lucblender/MultiTool-Midi-Board/Hardware/multi-tool-midi-board/multi-tool-midi-board.kicad_pcb

## KiCad design Hardware/multi-tool-midi-board/multi-tool-midi-board.kicad_pcb (2023-04-30)

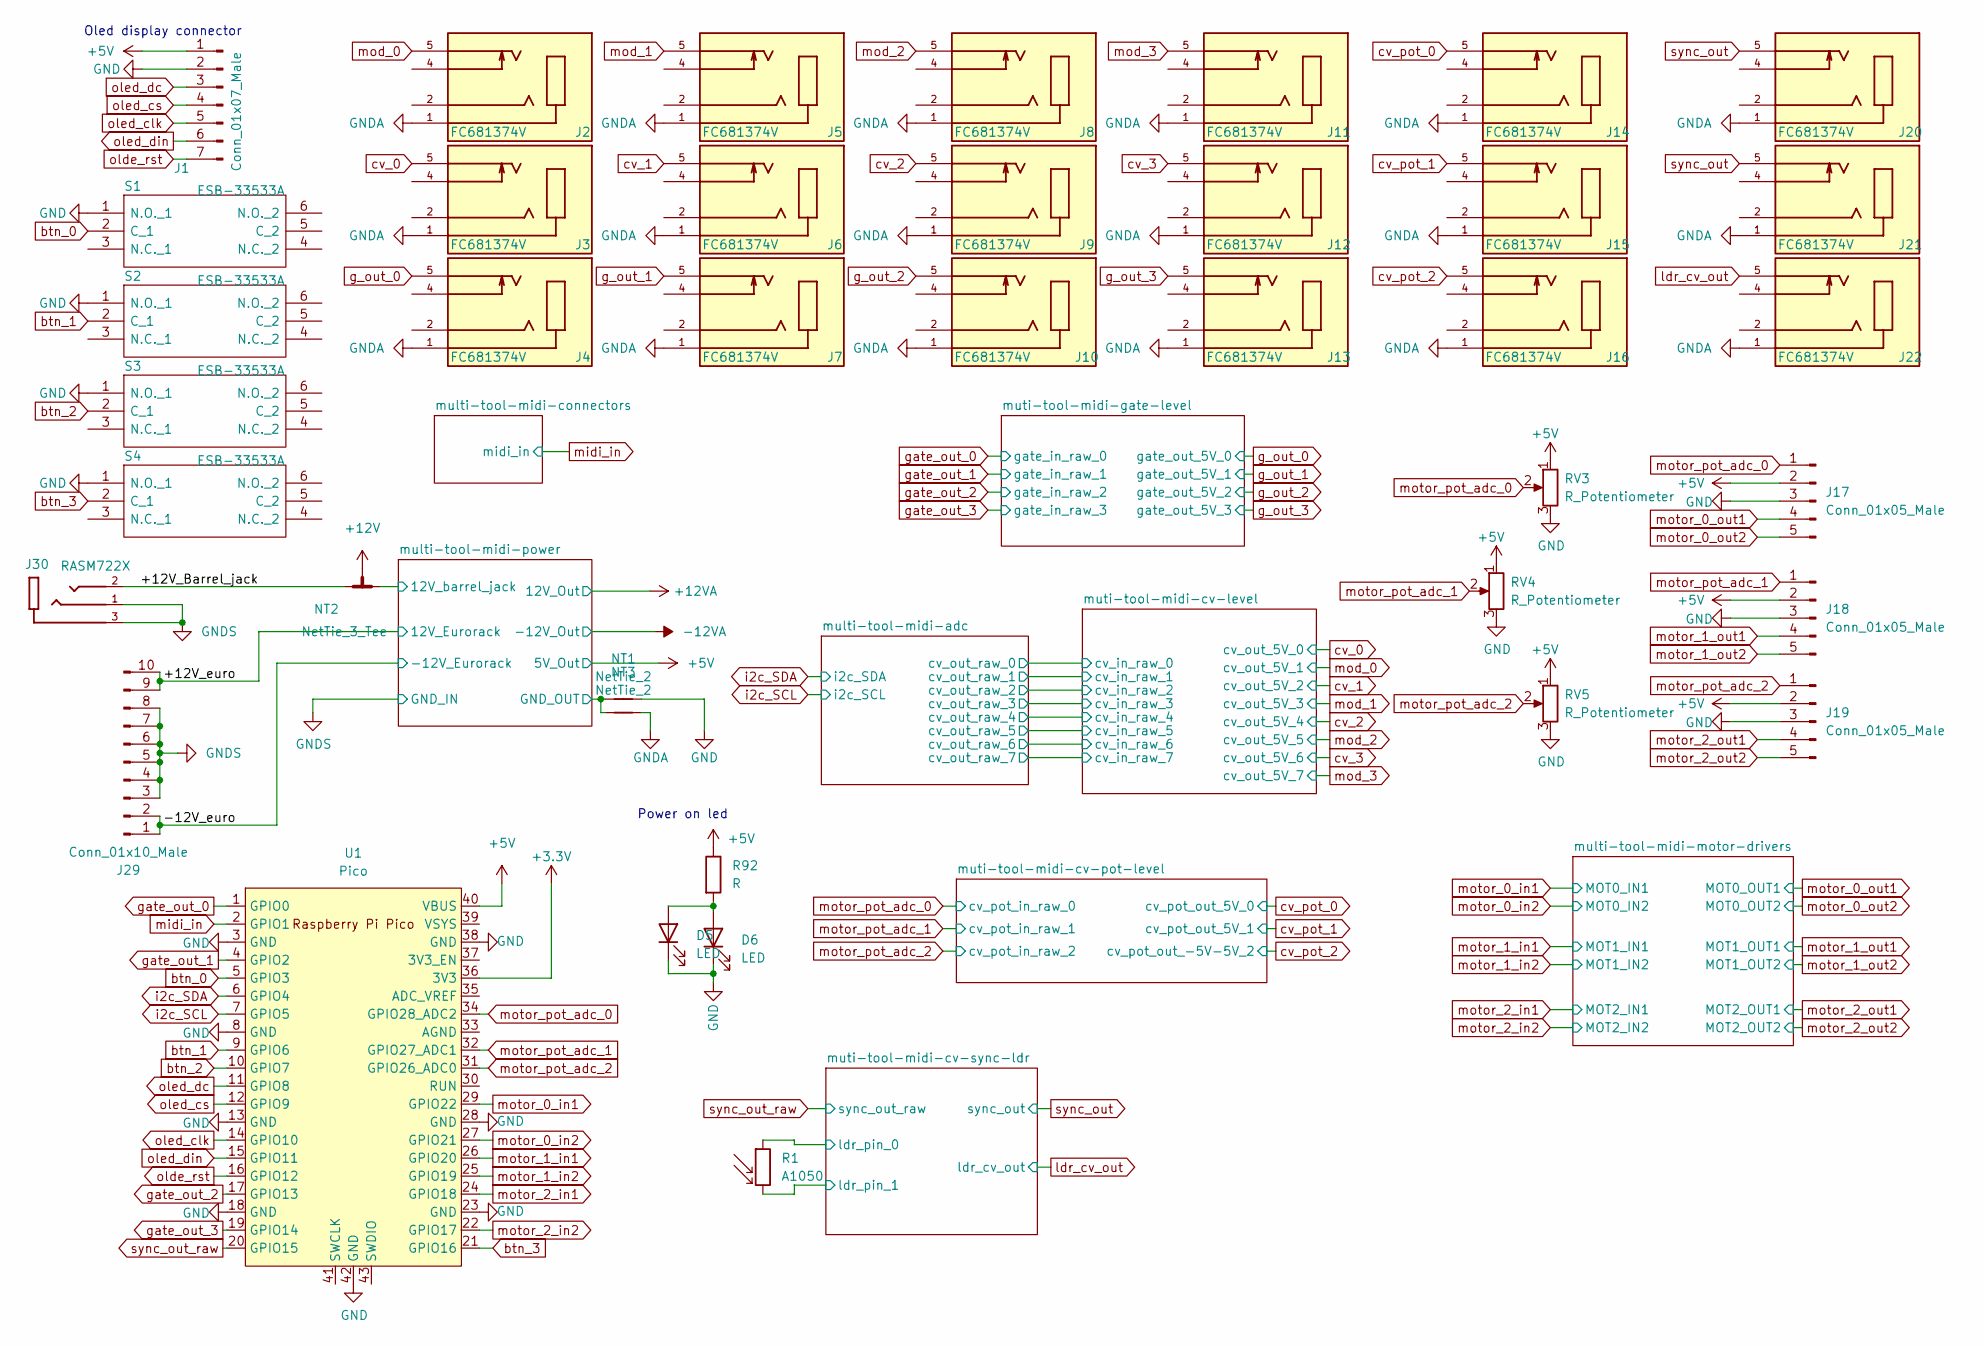
[picture p1: schematic multi-tool-midi-board.kicad_sch, Multi tool midi board]

Parts:
D5: LED; LED_D3.0mm
D6: LED; LED_0603_1608Metric
J1: Conn_01x07_Male; PinHeader_1x07_P2.54mm_Vertical
J2, J3, J4, J5, J6, J7, J8, J9, J10, J11, J12, J13, J14, J15, J16, J20, J21, J22: FC681374V; CLIFF_FC681374V
J17, J18, J19: Conn_01x05_Male; PinHeader_1x05_P2.54mm_Vertical
J29: Conn_01x10_Male; PinHeader_2x05_P2.54mm_Vertical
J30: RASM722X; SWITCHCRAFT_RASM722X; PARTREV A
NT1, NT3: NetTie_2; NetTie-2_SMD_Pad2.0mm
NT2: NetTie_3_Tee; NetTie-3_SMD_Pad2.0mm
R1: A1050; R_LDR_D6.4mm_P3.4mm_Vertical
R92: R; R_0805_2012Metric
RV3, RV4, RV5: R_Potentiometer; Potentiometer_Alpha_RD901F-40-00D_Single_Vertical
S1, S2, S3, S4: ESB-33533A; ESB33533A; Mouser Part Number 667-ESB-33533A
U1: Pico; RPi_Pico_SMD_TH

Connections:
+3V3: U1.36 (3V3); also elsewhere on the board
+5V: J1.1, J17.2, J18.2, J19.2, R92.1, RV3.1, RV4.1, RV5.1, U1.40 (VBUS); also elsewhere on the board
+12V: NT2.3; also elsewhere on the board
+12VA: R1.1; also elsewhere on the board
/+12V_Barrel_jack: J30.2, NT2.2
/+12V_euro: J29.9, J29.10; also elsewhere on the board
/-12V_euro: J29.1, J29.2; also elsewhere on the board
/multi-tool-midi-power/12V_barrel_jack: NT2.1; also elsewhere on the board
/muti-tool-midi-cv-sync-ldr/ldr_pin_1: R1.2; also elsewhere on the board
GND: D5.1 (K), D6.1 (K), J1.2, J17.3, J18.3, J19.3, NT1.2, RV3.3, RV4.3, RV5.3, S1.1 (N.O._1), S2.1 (N.O._1), S3.1 (N.O._1), S4.1 (N.O._1), U1.3 (GND), U1.8 (GND), U1.13 (GND), U1.18 (GND), U1.23 (GND), U1.28 (GND), U1.38 (GND), U1.42 (GND); also elsewhere on the board
GNDA: J2.1, J3.1, J4.1, J5.1, J6.1, J7.1, J8.1, J9.1, J10.1, J11.1, J12.1, J13.1, J14.1, J15.1, J16.1, J20.1, J21.1, J22.1, NT3.2; also elsewhere on the board
GNDS: J29.3, J29.4, J29.5, J29.6, J29.7, J29.8, J30.1, J30.3, NT1.1, NT3.1; also elsewhere on the board
unnamed: D5.2 (A), D6.2 (A), R92.2
btn_0: S1.2 (C_1), U1.5 (GPIO3)
btn_1: S2.2 (C_1), U1.9 (GPIO6)
btn_2: S3.2 (C_1), U1.10 (GPIO7)
btn_3: S4.2 (C_1), U1.21 (GPIO16)
cv_0: J3.5; also elsewhere on the board
cv_1: J6.5; also elsewhere on the board
cv_2: J9.5; also elsewhere on the board
cv_3: J12.5; also elsewhere on the board
cv_pot_0: J14.5; also elsewhere on the board
cv_pot_1: J15.5; also elsewhere on the board
cv_pot_2: J16.5; also elsewhere on the board
g_out_0: J4.5; also elsewhere on the board
g_out_1: J7.5; also elsewhere on the board
g_out_2: J10.5; also elsewhere on the board
g_out_3: J13.5; also elsewhere on the board
gate_out_0: U1.1 (GPIO0); also elsewhere on the board
gate_out_1: U1.4 (GPIO2); also elsewhere on the board
gate_out_2: U1.17 (GPIO13); also elsewhere on the board
gate_out_3: U1.19 (GPIO14); also elsewhere on the board
i2c_SCL: U1.7 (GPIO5); also elsewhere on the board
i2c_SDA: U1.6 (GPIO4); also elsewhere on the board
ldr_cv_out: J22.5; also elsewhere on the board
midi_in: U1.2 (GPIO1); also elsewhere on the board
mod_0: J2.5; also elsewhere on the board
mod_1: J5.5; also elsewhere on the board
mod_2: J8.5; also elsewhere on the board
mod_3: J11.5; also elsewhere on the board
motor_0_in1: U1.29 (GPIO22); also elsewhere on the board
motor_0_in2: U1.27 (GPIO21); also elsewhere on the board
motor_0_out1: J17.4; also elsewhere on the board
motor_0_out2: J17.5; also elsewhere on the board
motor_1_in1: U1.26 (GPIO20); also elsewhere on the board
motor_1_in2: U1.25 (GPIO19); also elsewhere on the board
motor_1_out1: J18.4; also elsewhere on the board
motor_1_out2: J18.5; also elsewhere on the board
motor_2_in1: U1.24 (GPIO18); also elsewhere on the board
motor_2_in2: U1.22 (GPIO17); also elsewhere on the board
motor_2_out1: J19.4; also elsewhere on the board
motor_2_out2: J19.5; also elsewhere on the board
motor_pot_adc_0: J17.1, RV3.2, U1.34 (GPIO28_ADC2); also elsewhere on the board
motor_pot_adc_1: J18.1, RV4.2, U1.32 (GPIO27_ADC1); also elsewhere on the board
motor_pot_adc_2: J19.1, RV5.2, U1.31 (GPIO26_ADC0); also elsewhere on the board
olde_rst: J1.7, U1.16 (GPIO12)
oled_clk: J1.5, U1.14 (GPIO10)
oled_cs: J1.4, U1.12 (GPIO9)
oled_dc: J1.3, U1.11 (GPIO8)
oled_din: J1.6, U1.15 (GPIO11)
sync_out: J20.5, J21.5; also elsewhere on the board
sync_out_raw: U1.20 (GPIO15); also elsewhere on the board

Notes on the sheet:
Power on led
Oled display connector

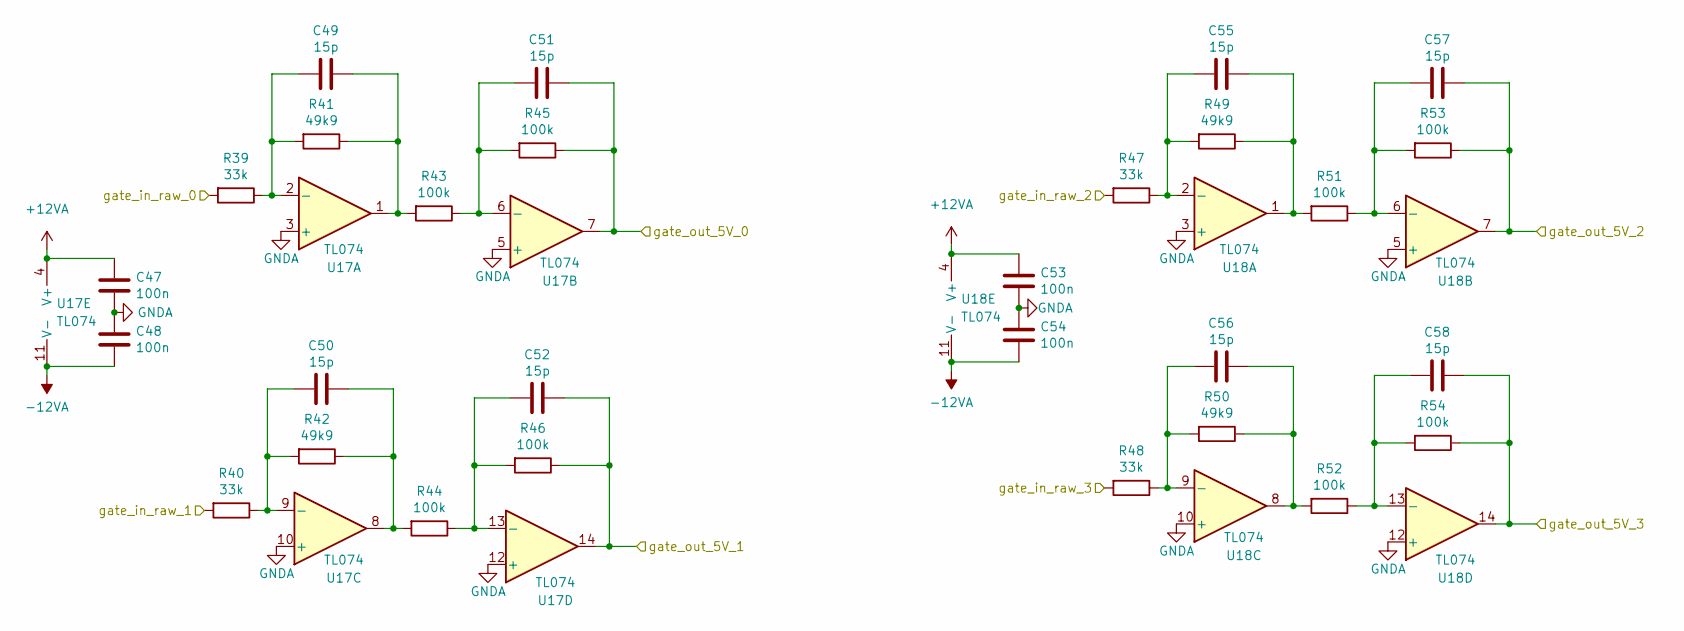
[picture p2: schematic muti-tool-midi-gate-level.kicad_sch]

Parts:
C47, C48, C53, C54: 100n; C_0603_1608Metric; LCSC C14663
C49, C50, C51, C52, C55, C56, C57, C58: 15p; C_0603_1608Metric; LCSC C14663
R39, R40, R47, R48: 33k; R_0603_1608Metric; LCSC C25804
R41, R42, R49, R50: 49k9; R_0603_1608Metric; LCSC C25804
R43, R44, R45, R46, R51, R52, R53, R54: 100k; R_0603_1608Metric; LCSC C25804
U17, U18: TL074; SOP50P326X110-14N

Connections:
+12VA: C47.1, C53.1, U17.4 (V+), U18.4 (V+); also elsewhere on the board
-12VA: C48.2, C54.2, U17.11 (V-), U18.11 (V-); also elsewhere on the board
GNDA: C47.2, C48.1, C53.2, C54.1, U17.3 (+), U17.5 (+), U17.10 (+), U17.12 (+), U18.3 (+), U18.5 (+), U18.10 (+), U18.12 (+); also elsewhere on the board
unnamed: C49.1, R39.1, R41.2, U17.2 (-)
unnamed: C49.2, R41.1, R43.2, U17.1
unnamed: C50.1, R40.1, R42.2, U17.9 (-)
unnamed: C50.2, R42.1, R44.2, U17.8
unnamed: C51.1, R43.1, R45.2, U17.6 (-)
unnamed: C52.1, R44.1, R46.2, U17.13 (-)
unnamed: C55.1, R47.1, R49.2, U18.2 (-)
unnamed: C55.2, R49.1, R51.2, U18.1
unnamed: C56.1, R48.1, R50.2, U18.9 (-)
unnamed: C56.2, R50.1, R52.2, U18.8
unnamed: C57.1, R51.1, R53.2, U18.6 (-)
unnamed: C58.1, R52.1, R54.2, U18.13 (-)
g_out_0: C51.2, R45.1, U17.7; also elsewhere on the board
g_out_1: C52.2, R46.1, U17.14; also elsewhere on the board
g_out_2: C57.2, R53.1, U18.7; also elsewhere on the board
g_out_3: C58.2, R54.1, U18.14; also elsewhere on the board
gate_out_0: R39.2; also elsewhere on the board
gate_out_1: R40.2; also elsewhere on the board
gate_out_2: R47.2; also elsewhere on the board
gate_out_3: R48.2; also elsewhere on the board

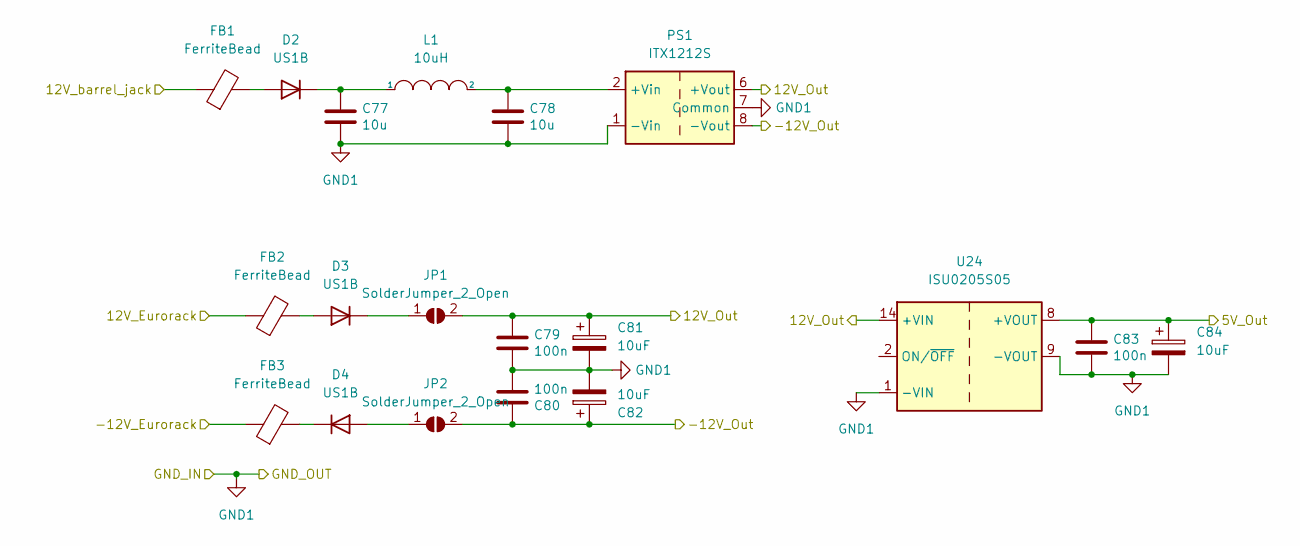
[picture p3: schematic multi-tool-midi-power.kicad_sch]

Parts:
C77, C78: 10u; C_0603_1608Metric; LCSC C14663
C79, C80, C83: 100n; C_0603_1608Metric; LCSC C14663
C81, C82, C84: 10uF; CP_Elec_6.3x5.9
D2, D3, D4: US1B; D_SMA
FB1, FB2, FB3: FerriteBead; L_0805_2012Metric
JP1, JP2: SolderJumper_2_Open; SolderJumper-2_P1.3mm_Open_TrianglePad1.0x1.5mm
L1: 10uH; L_0805_2012Metric
PS1: ITX1212S; Converter_DCDC_XP_POWER-ITxxxxxS_THT
U24: ISU0205S05; Converter_DCDC_XP_POWER-ISU02_SMD

Connections:
+5V: C83.1, C84.1, U24.8 (+VOUT); also elsewhere on the board
+12VA: C79.1, C81.1, JP1.2 (B), PS1.6 (+Vout), U24.14 (+VIN); also elsewhere on the board
-12VA: C80.1, C82.1, JP2.2 (B), PS1.8 (-Vout); also elsewhere on the board
/+12V_euro: FB2.1; also elsewhere on the board
/-12V_euro: FB3.1; also elsewhere on the board
/multi-tool-midi-power/12V_barrel_jack: FB1.1; also elsewhere on the board
GNDS: C77.2, C78.2, C79.2, C80.2, C81.2, C82.2, C83.2, C84.2, PS1.1 (-Vin), PS1.7 (Common), U24.1 (-VIN), U24.9 (-VOUT); also elsewhere on the board
unnamed: C77.1, D2.1 (K), L1.1
unnamed: C78.1, L1.2, PS1.2 (+Vin)
unnamed: D2.2 (A), FB1.2
unnamed: D3.1 (K), JP1.1 (A)
unnamed: D3.2 (A), FB2.2
unnamed: D4.1 (K), FB3.2
unnamed: D4.2 (A), JP2.1 (A)

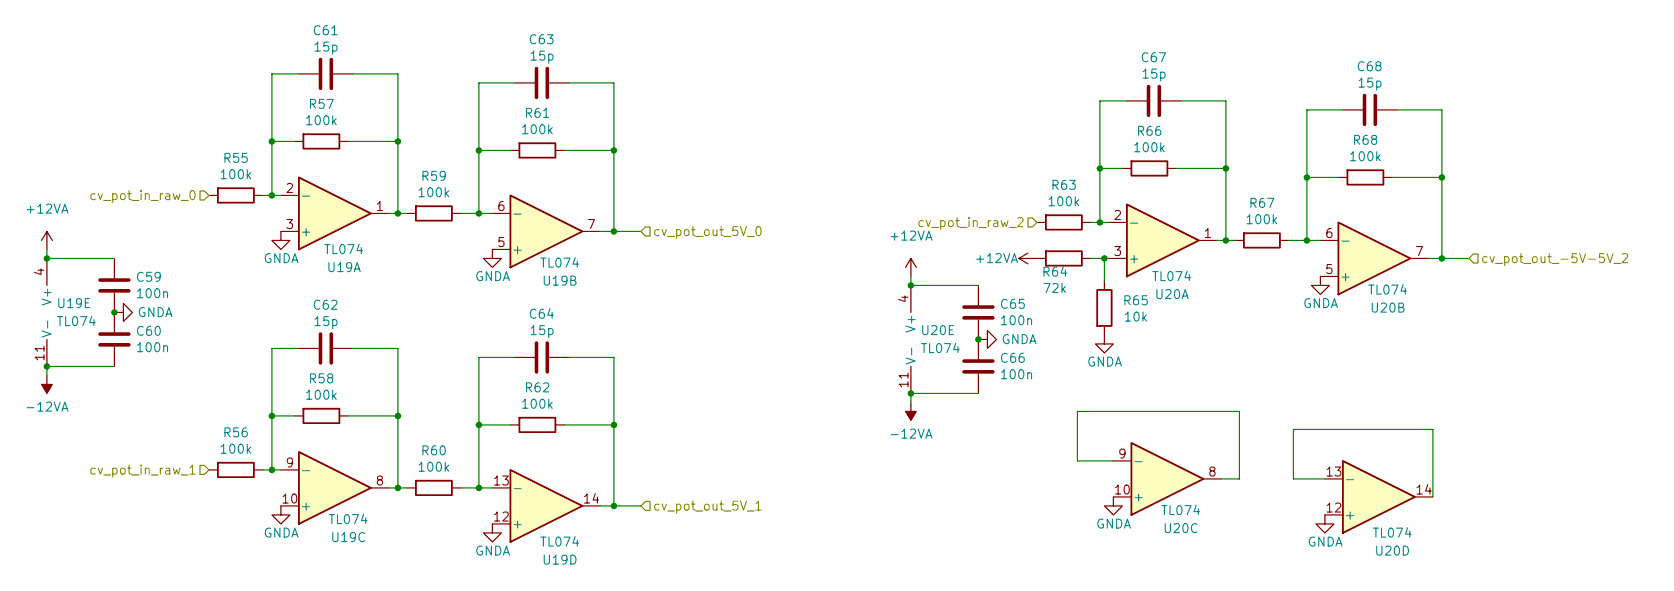
[picture p4: schematic muti-tool-midi-cv-pot-level.kicad_sch]

Parts:
C59, C60, C65, C66: 100n; C_0603_1608Metric; LCSC C14663
C61, C62, C63, C64, C67, C68: 15p; C_0603_1608Metric; LCSC C14663
R55, R56, R57, R58, R59, R60, R61, R62, R63, R66, R67, R68: 100k; R_0603_1608Metric; LCSC C25804
R64: 72k; R_0603_1608Metric; LCSC C25804
R65: 10k; R_0603_1608Metric; LCSC C25804
U19, U20: TL074; SOP50P326X110-14N

Connections:
+12VA: C59.1, C65.1, R64.2, U19.4 (V+), U20.4 (V+); also elsewhere on the board
-12VA: C60.2, C66.2, U19.11 (V-), U20.11 (V-); also elsewhere on the board
GNDA: C59.2, C60.1, C65.2, C66.1, R65.2, U19.3 (+), U19.5 (+), U19.10 (+), U19.12 (+), U20.5 (+), U20.10 (+), U20.12 (+); also elsewhere on the board
unnamed: C61.1, R55.1, R57.2, U19.2 (-)
unnamed: C61.2, R57.1, R59.2, U19.1
unnamed: C62.1, R56.1, R58.2, U19.9 (-)
unnamed: C62.2, R58.1, R60.2, U19.8
unnamed: C63.1, R59.1, R61.2, U19.6 (-)
unnamed: C64.1, R60.1, R62.2, U19.13 (-)
unnamed: C67.1, R63.1, R66.2, U20.2 (-)
unnamed: C67.2, R66.1, R67.2, U20.1
unnamed: C68.1, R67.1, R68.2, U20.6 (-)
unnamed: R64.1, R65.1, U20.3 (+)
unnamed: U20.8, U20.9 (-)
unnamed: U20.13 (-), U20.14
cv_pot_0: C63.2, R61.1, U19.7; also elsewhere on the board
cv_pot_1: C64.2, R62.1, U19.14; also elsewhere on the board
cv_pot_2: C68.2, R68.1, U20.7; also elsewhere on the board
motor_pot_adc_0: R55.2; also elsewhere on the board
motor_pot_adc_1: R56.2; also elsewhere on the board
motor_pot_adc_2: R63.2; also elsewhere on the board

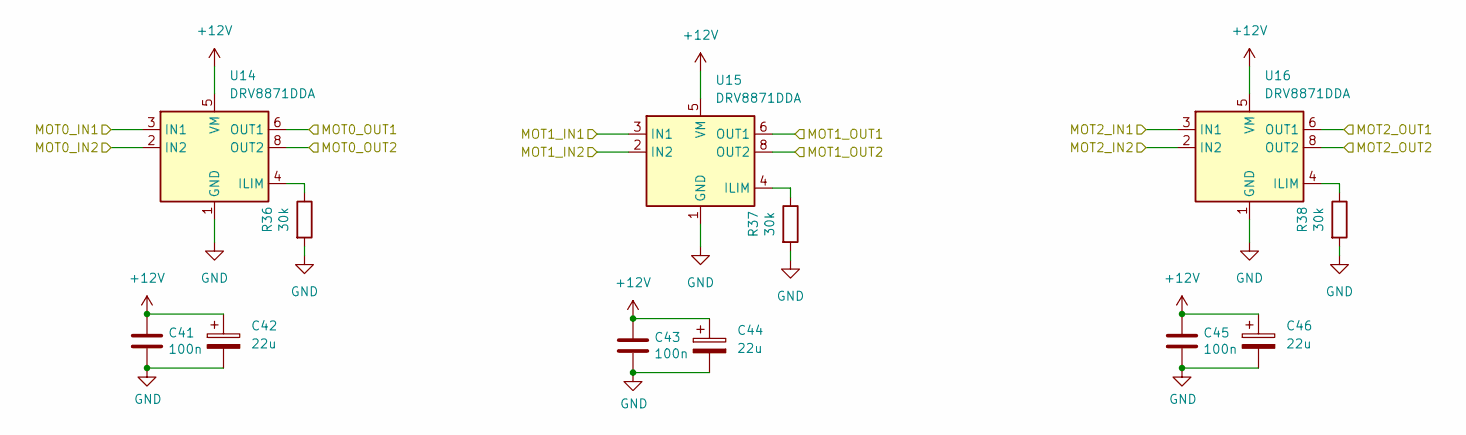
[picture p5: schematic multi-tool-midi-motor-drivers.kicad_sch]

Parts:
C41, C43, C45: 100n; C_0603_1608Metric; LCSC C14663
C42, C44, C46: 22u; CP_Elec_6.3x5.9
R36, R37, R38: 30k; R_0603_1608Metric; LCSC C25804
U14, U15, U16: DRV8871DDA; Texas_HTSOP-8-1EP_3.9x4.9mm_P1.27mm_EP2.95x4.9mm_Mask2.4x3.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

Connections:
+12V: C41.1, C42.1, C43.1, C44.1, C45.1, C46.1, U14.5 (VM), U15.5 (VM), U16.5 (VM); also elsewhere on the board
GND: C41.2, C42.2, C43.2, C44.2, C45.2, C46.2, R36.2, R37.2, R38.2, U14.1 (GND), U14.7 (GND), U14.9 (GND), U15.1 (GND), U15.7 (GND), U15.9 (GND), U16.1 (GND), U16.7 (GND), U16.9 (GND); also elsewhere on the board
unnamed: R36.1, U14.4 (ILIM)
unnamed: R37.1, U15.4 (ILIM)
unnamed: R38.1, U16.4 (ILIM)
motor_0_in1: U14.3 (IN1); also elsewhere on the board
motor_0_in2: U14.2 (IN2); also elsewhere on the board
motor_0_out1: U14.6 (OUT1); also elsewhere on the board
motor_0_out2: U14.8 (OUT2); also elsewhere on the board
motor_1_in1: U15.3 (IN1); also elsewhere on the board
motor_1_in2: U15.2 (IN2); also elsewhere on the board
motor_1_out1: U15.6 (OUT1); also elsewhere on the board
motor_1_out2: U15.8 (OUT2); also elsewhere on the board
motor_2_in1: U16.3 (IN1); also elsewhere on the board
motor_2_in2: U16.2 (IN2); also elsewhere on the board
motor_2_out1: U16.6 (OUT1); also elsewhere on the board
motor_2_out2: U16.8 (OUT2); also elsewhere on the board

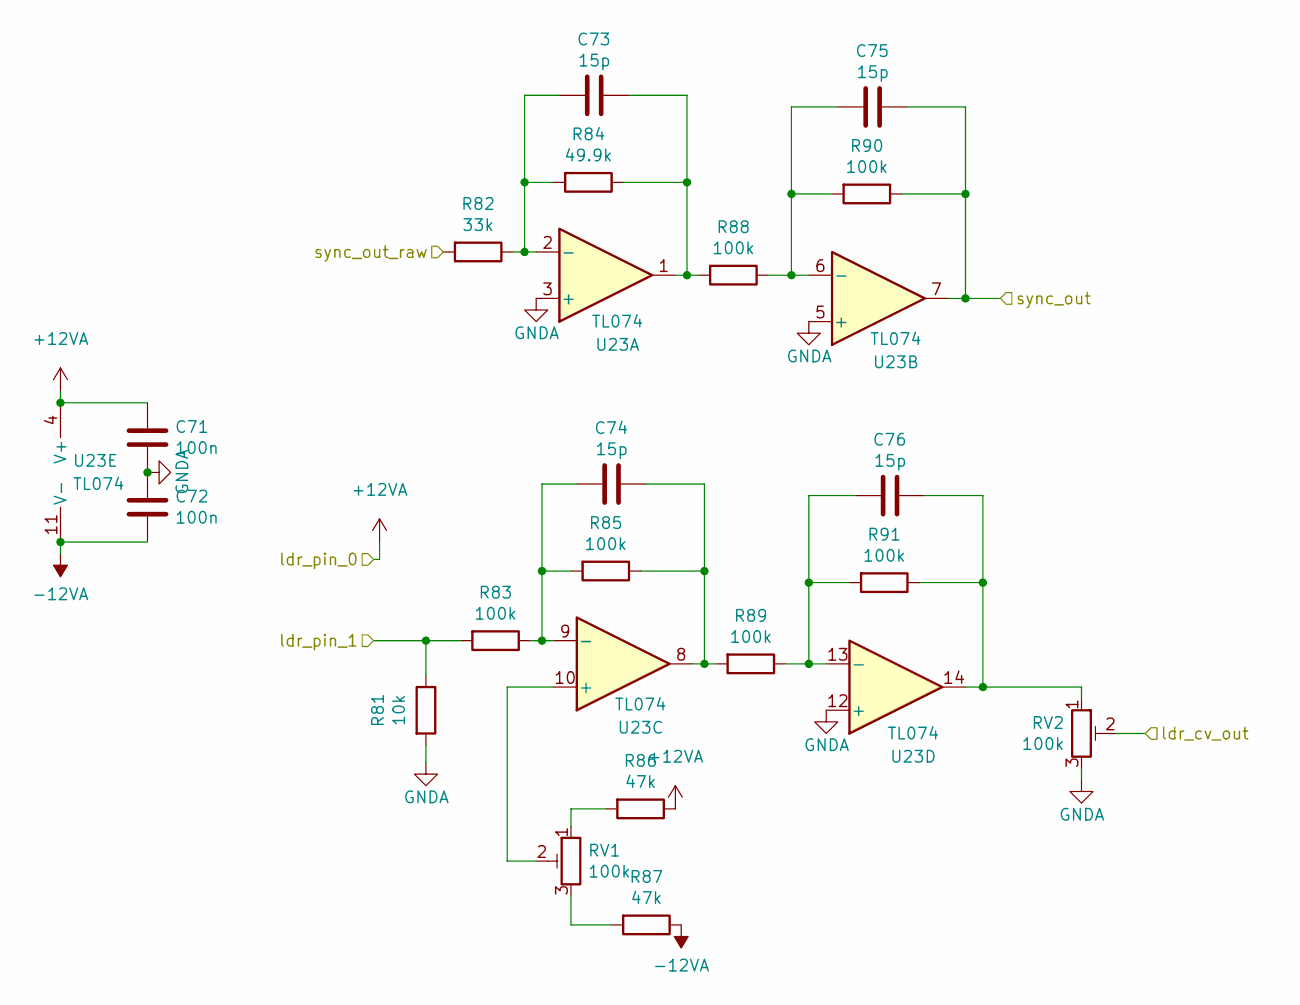
[picture p6: schematic muti-tool-midi-cv-sync-ldr.kicad_sch]

Parts:
C71, C72: 100n; C_0603_1608Metric; LCSC C14663
C73, C74, C75, C76: 15p; C_0603_1608Metric; LCSC C14663
R81: 10k; R_0603_1608Metric; LCSC C25804
R82: 33k; R_0603_1608Metric; LCSC C25804
R83, R85, R88, R89, R90, R91: 100k; R_0603_1608Metric; LCSC C25804
R84: 49.9k; R_0603_1608Metric; LCSC C25804
R86, R87: 47k; R_0603_1608Metric; LCSC C25804
RV1, RV2: 100k; Potentiometer_Vishay_TS53YL_Vertical
U23: TL074; SOP50P326X110-14N

Connections:
+12VA: C71.1, R86.1, U23.4 (V+); also elsewhere on the board
-12VA: C72.2, R87.1, U23.11 (V-); also elsewhere on the board
/muti-tool-midi-cv-sync-ldr/ldr_pin_1: R81.1, R83.2; also elsewhere on the board
GNDA: C71.2, C72.1, R81.2, RV2.3, U23.3 (+), U23.5 (+), U23.12 (+); also elsewhere on the board
unnamed: C73.1, R82.1, R84.2, U23.2 (-)
unnamed: C73.2, R84.1, R88.2, U23.1
unnamed: C74.1, R83.1, R85.2, U23.9 (-)
unnamed: C74.2, R85.1, R89.2, U23.8
unnamed: C75.1, R88.1, R90.2, U23.6 (-)
unnamed: C76.1, R89.1, R91.2, U23.13 (-)
unnamed: C76.2, R91.1, RV2.1, U23.14
unnamed: R86.2, RV1.1
unnamed: R87.2, RV1.3
unnamed: RV1.2, U23.10 (+)
ldr_cv_out: RV2.2; also elsewhere on the board
sync_out: C75.2, R90.1, U23.7; also elsewhere on the board
sync_out_raw: R82.2; also elsewhere on the board

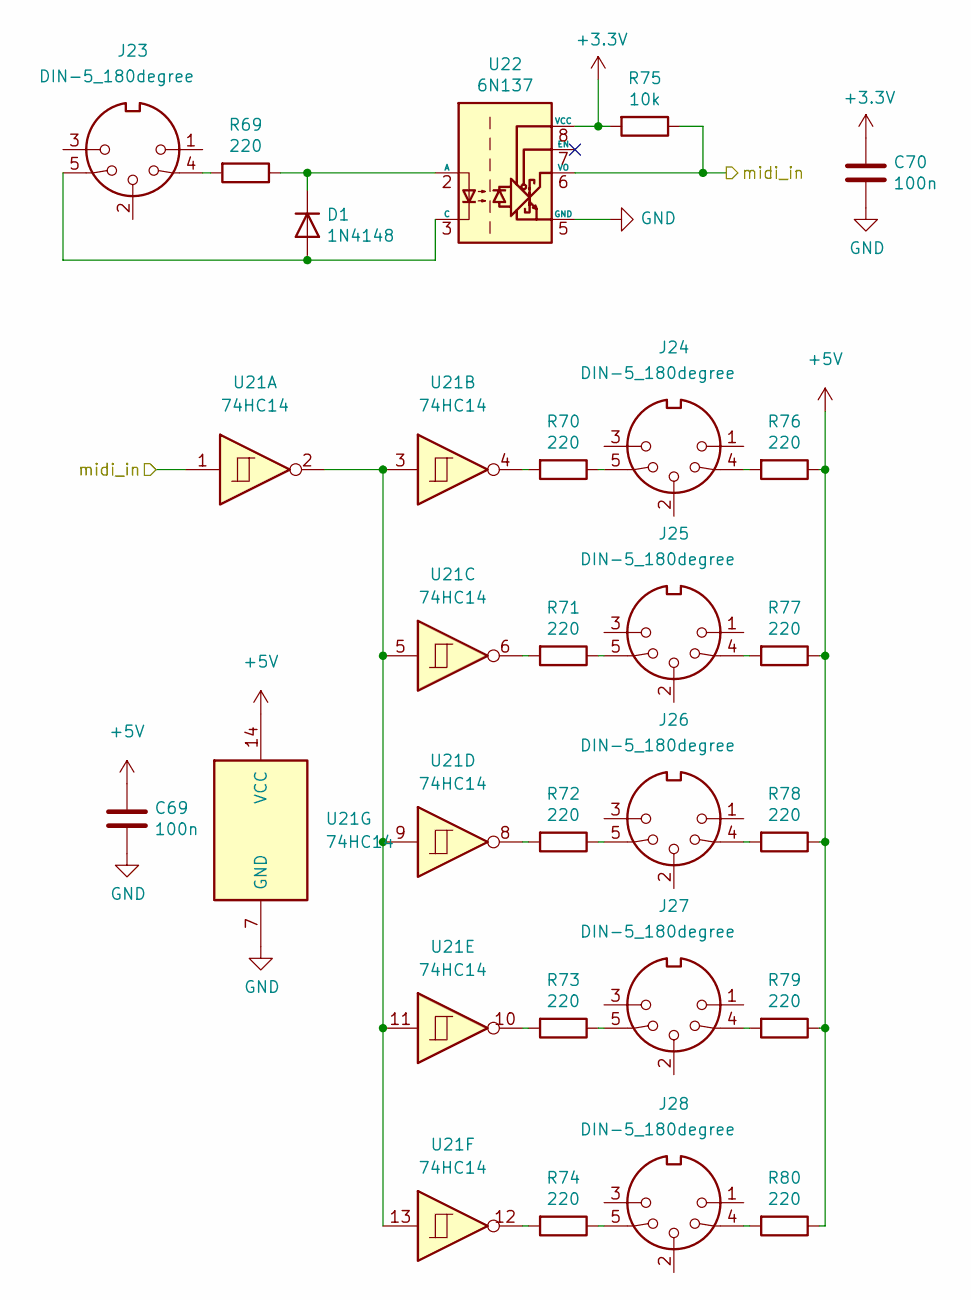
[picture p7: schematic multi-tool-midi-connectors.kicad_sch]

Parts:
C69, C70: 100n; C_0603_1608Metric; LCSC C14663
D1: 1N4148; D_SOD-123; LCSC C81598
J23, J24, J25, J26, J27, J28: DIN-5_180degree; CUI_SD-50BV
R69: 220; R_0603_1608Metric; LCSC C22962
R70, R71, R72, R73, R74, R76, R77, R78, R79, R80: 220; R_0603_1608Metric; LCSC C25804
R75: 10k; R_0603_1608Metric; LCSC C25804
U21: 74HC14; SOIC-14_3.9x8.7mm_P1.27mm
U22: 6N137; SMDIP-8_W9.53mm; LCSC C110020

Connections:
+3V3: C70.1, R75.2, U22.8 (VCC); also elsewhere on the board
+5V: C69.1, R76.1, R77.1, R78.1, R79.1, R80.1, U21.14 (VCC); also elsewhere on the board
GND: C69.2, C70.2, U21.7 (GND), U22.5 (GND); also elsewhere on the board
unnamed: D1.1 (K), R69.1, U22.2 (A)
unnamed: D1.2 (A), J23.5, U22.3 (C)
unnamed: J23.4, R69.2
unnamed: J24.4, R76.2
unnamed: J24.5, R70.1
unnamed: J25.4, R77.2
unnamed: J25.5, R71.1
unnamed: J26.4, R78.2
unnamed: J26.5, R72.1
unnamed: J27.4, R79.2
unnamed: J27.5, R73.1
unnamed: J28.4, R80.2
unnamed: J28.5, R74.1
unnamed: R70.2, U21.4
unnamed: R71.2, U21.6
unnamed: R72.2, U21.8
unnamed: R73.2, U21.10
unnamed: R74.2, U21.12
unnamed: U21.2, U21.3, U21.5, U21.9, U21.11, U21.13
midi_in: R75.1, U21.1, U22.6 (VO); also elsewhere on the board

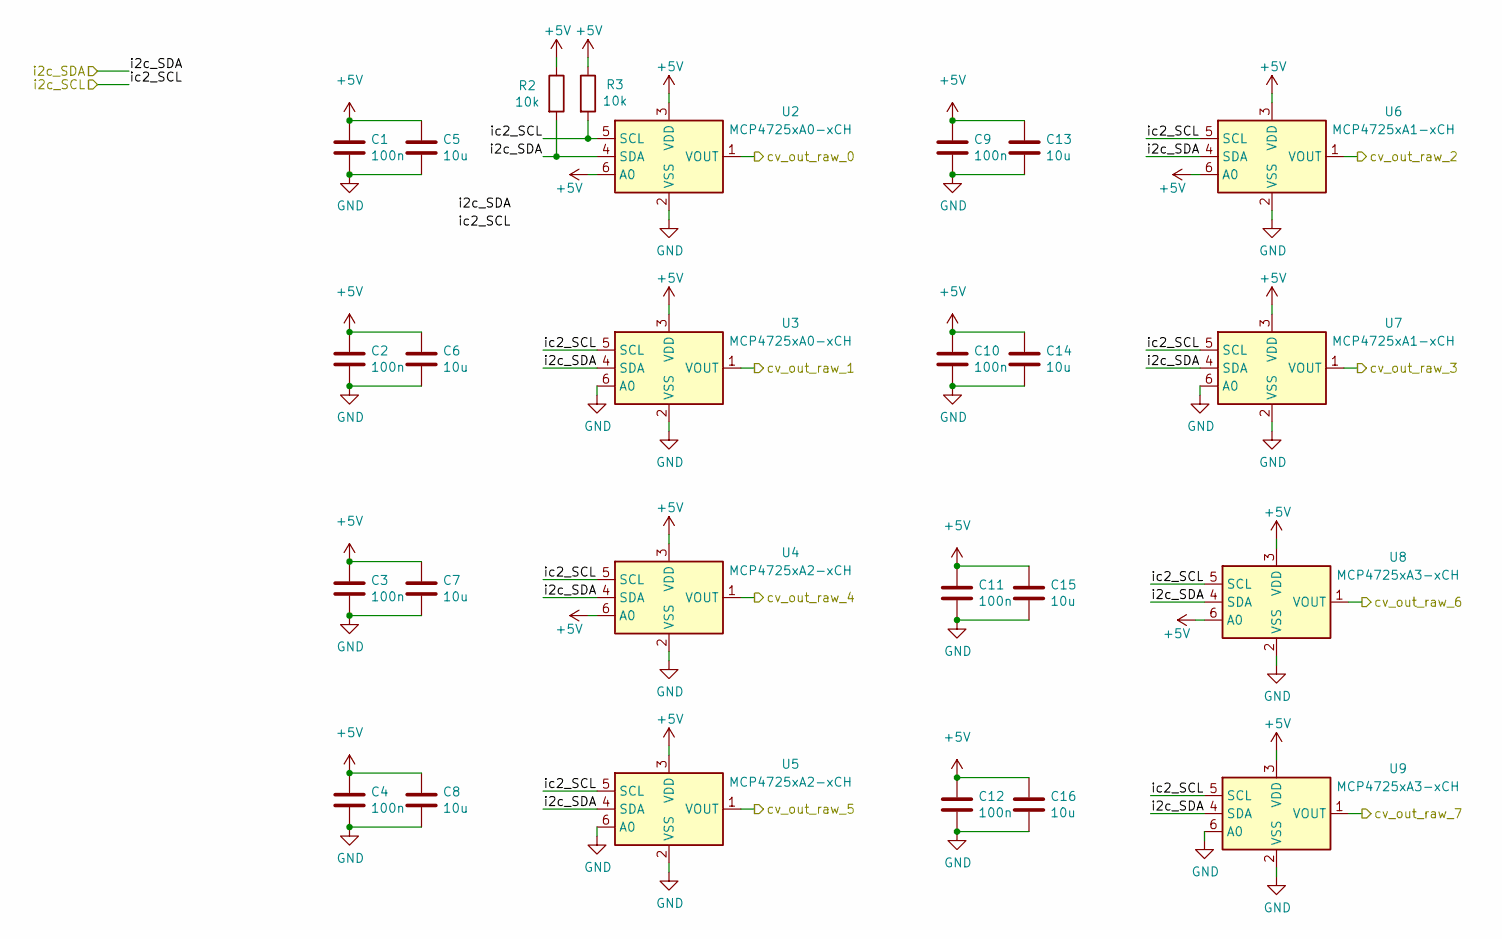
[picture p8: schematic multi-tool-midi-adc.kicad_sch]

Parts:
C1, C2, C3, C4, C9, C10, C11, C12: 100n; C_0603_1608Metric; LCSC C14663
C5, C6, C7, C8, C13, C14, C15, C16: 10u; C_0603_1608Metric; LCSC C14663
R2, R3: 10k; R_0603_1608Metric; LCSC C25804
U2, U3: MCP4725xA0-xCH; SOT-23-6
U4, U5: MCP4725xA2-xCH; SOT-23-6
U6, U7: MCP4725xA1-xCH; SOT-23-6
U8, U9: MCP4725xA3-xCH; SOT-23-6

Connections:
+5V: C1.1, C2.1, C3.1, C4.1, C5.1, C6.1, C7.1, C8.1, C9.1, C10.1, C11.1, C12.1, C13.1, C14.1, C15.1, C16.1, R2.1, R3.1, U2.3 (VDD), U2.6 (A0), U3.3 (VDD), U4.3 (VDD), U4.6 (A0), U5.3 (VDD), U6.3 (VDD), U6.6 (A0), U7.3 (VDD), U8.3 (VDD), U8.6 (A0), U9.3 (VDD); also elsewhere on the board
/multi-tool-midi-adc/cv_out_raw_0: U2.1 (VOUT); also elsewhere on the board
/multi-tool-midi-adc/cv_out_raw_1: U3.1 (VOUT); also elsewhere on the board
/multi-tool-midi-adc/cv_out_raw_2: U6.1 (VOUT); also elsewhere on the board
/multi-tool-midi-adc/cv_out_raw_3: U7.1 (VOUT); also elsewhere on the board
/multi-tool-midi-adc/cv_out_raw_4: U4.1 (VOUT); also elsewhere on the board
/multi-tool-midi-adc/cv_out_raw_5: U5.1 (VOUT); also elsewhere on the board
/multi-tool-midi-adc/cv_out_raw_6: U8.1 (VOUT); also elsewhere on the board
/multi-tool-midi-adc/cv_out_raw_7: U9.1 (VOUT); also elsewhere on the board
GND: C1.2, C2.2, C3.2, C4.2, C5.2, C6.2, C7.2, C8.2, C9.2, C10.2, C11.2, C12.2, C13.2, C14.2, C15.2, C16.2, U2.2 (VSS), U3.2 (VSS), U3.6 (A0), U4.2 (VSS), U5.2 (VSS), U5.6 (A0), U6.2 (VSS), U7.2 (VSS), U7.6 (A0), U8.2 (VSS), U9.2 (VSS), U9.6 (A0); also elsewhere on the board
i2c_SCL: R3.2, U2.5 (SCL), U3.5 (SCL), U4.5 (SCL), U5.5 (SCL), U6.5 (SCL), U7.5 (SCL), U8.5 (SCL), U9.5 (SCL); also elsewhere on the board
i2c_SDA: R2.2, U2.4 (SDA), U3.4 (SDA), U4.4 (SDA), U5.4 (SDA), U6.4 (SDA), U7.4 (SDA), U8.4 (SDA), U9.4 (SDA); also elsewhere on the board

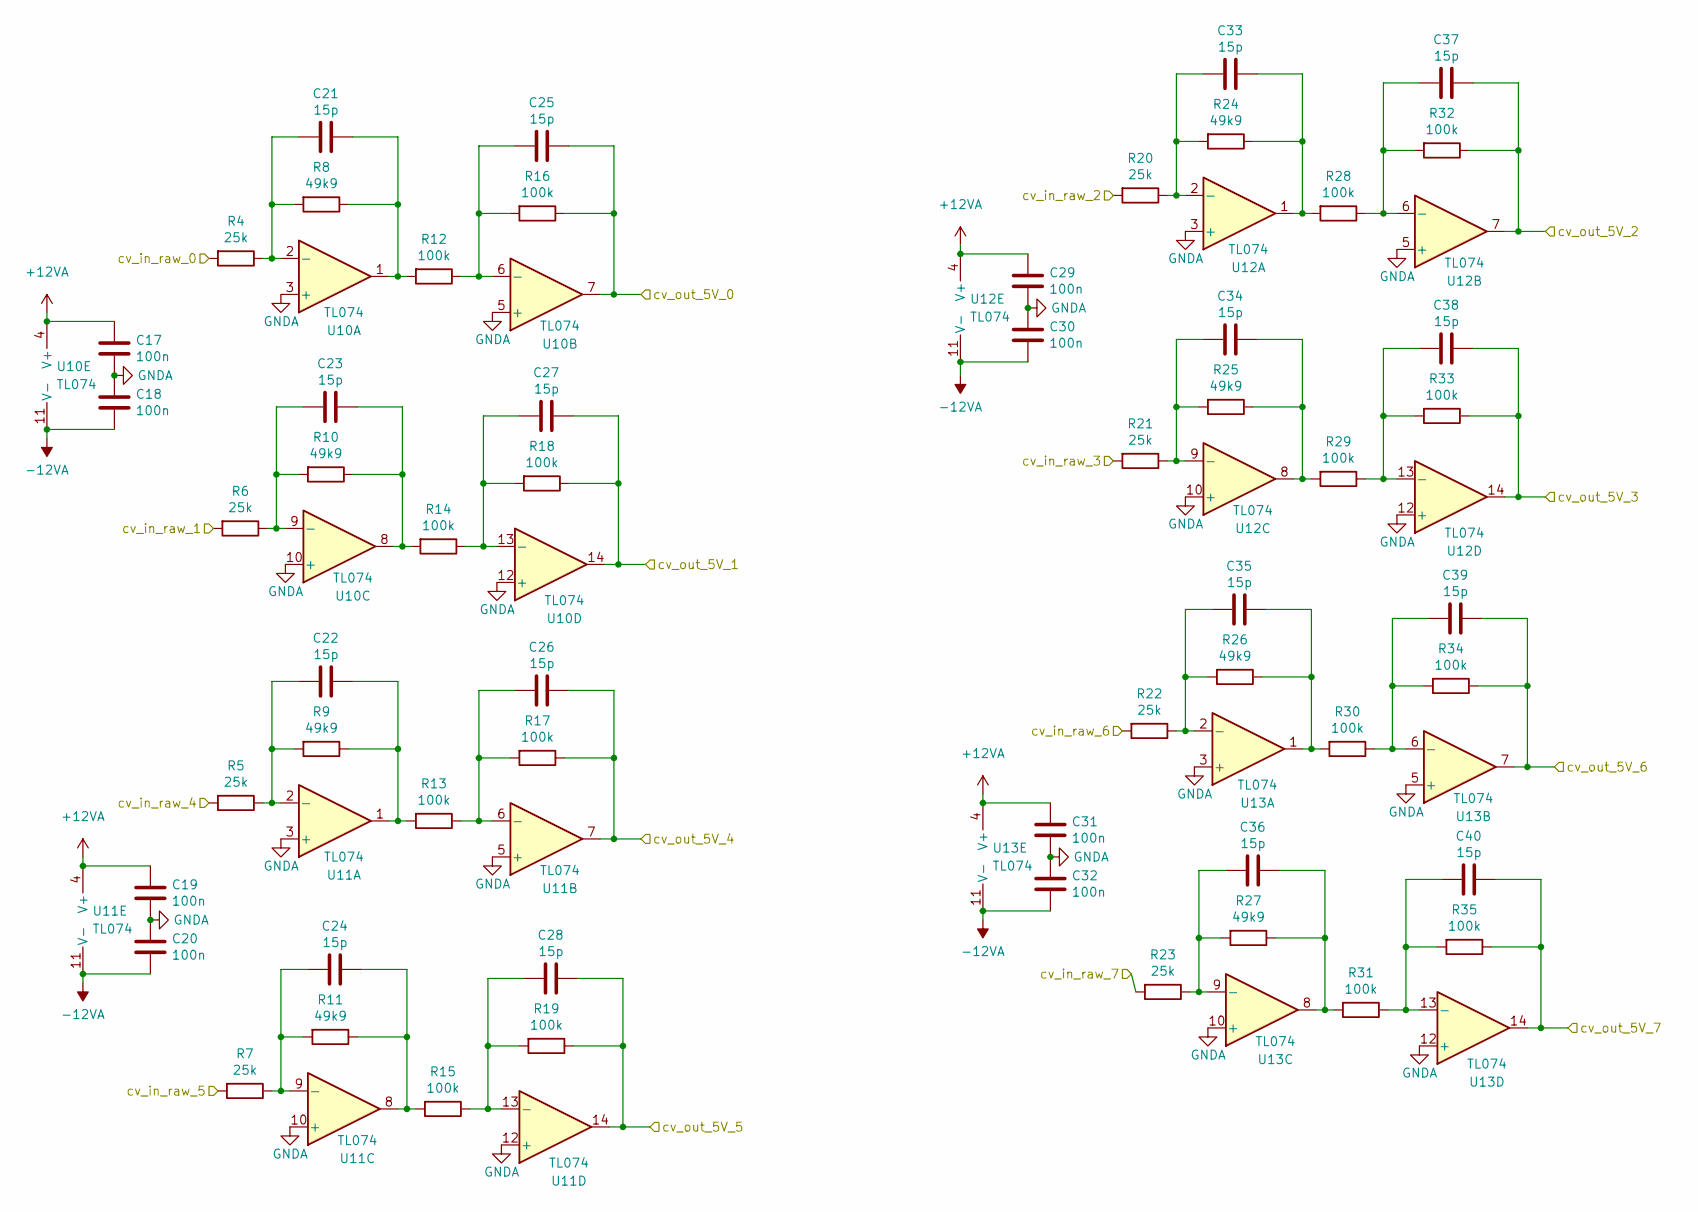
[picture p9: schematic muti-tool-midi-cv-level.kicad_sch]

Parts:
C17, C18, C19, C20, C29, C30, C31, C32: 100n; C_0603_1608Metric; LCSC C14663
C21, C22, C23, C24, C25, C26, C27, C28, C33, C34, C35, C36, C37, C38, C39, C40: 15p; C_0603_1608Metric; LCSC C14663
R4, R5, R6, R7, R20, R21, R22, R23: 25k; R_0603_1608Metric; LCSC C25804
R8, R9, R10, R11, R24, R25, R26, R27: 49k9; R_0603_1608Metric; LCSC C25804
R12, R13, R14, R15, R16, R17, R18, R19, R28, R29, R30, R31, R32, R33, R34, R35: 100k; R_0603_1608Metric; LCSC C25804
U10, U11, U12, U13: TL074; SOP50P326X110-14N

Connections:
+12VA: C17.1, C19.1, C29.1, C31.1, U10.4 (V+), U11.4 (V+), U12.4 (V+), U13.4 (V+); also elsewhere on the board
-12VA: C18.2, C20.2, C30.2, C32.2, U10.11 (V-), U11.11 (V-), U12.11 (V-), U13.11 (V-); also elsewhere on the board
/multi-tool-midi-adc/cv_out_raw_0: R4.2; also elsewhere on the board
/multi-tool-midi-adc/cv_out_raw_1: R6.2; also elsewhere on the board
/multi-tool-midi-adc/cv_out_raw_2: R20.2; also elsewhere on the board
/multi-tool-midi-adc/cv_out_raw_3: R21.2; also elsewhere on the board
/multi-tool-midi-adc/cv_out_raw_4: R5.2; also elsewhere on the board
/multi-tool-midi-adc/cv_out_raw_5: R7.2; also elsewhere on the board
/multi-tool-midi-adc/cv_out_raw_6: R22.2; also elsewhere on the board
/multi-tool-midi-adc/cv_out_raw_7: R23.2; also elsewhere on the board
GNDA: C17.2, C18.1, C19.2, C20.1, C29.2, C30.1, C31.2, C32.1, U10.3 (+), U10.5 (+), U10.10 (+), U10.12 (+), U11.3 (+), U11.5 (+), U11.10 (+), U11.12 (+), U12.3 (+), U12.5 (+), U12.10 (+), U12.12 (+), U13.3 (+), U13.5 (+), U13.10 (+), U13.12 (+); also elsewhere on the board
unnamed: C21.1, R4.1, R8.2, U10.2 (-)
unnamed: C21.2, R8.1, R12.2, U10.1
unnamed: C22.1, R5.1, R9.2, U11.2 (-)
unnamed: C22.2, R9.1, R13.2, U11.1
unnamed: C23.1, R6.1, R10.2, U10.9 (-)
unnamed: C23.2, R10.1, R14.2, U10.8
unnamed: C24.1, R7.1, R11.2, U11.9 (-)
unnamed: C24.2, R11.1, R15.2, U11.8
unnamed: C25.1, R12.1, R16.2, U10.6 (-)
unnamed: C26.1, R13.1, R17.2, U11.6 (-)
unnamed: C27.1, R14.1, R18.2, U10.13 (-)
unnamed: C28.1, R15.1, R19.2, U11.13 (-)
unnamed: C33.1, R20.1, R24.2, U12.2 (-)
unnamed: C33.2, R24.1, R28.2, U12.1
unnamed: C34.1, R21.1, R25.2, U12.9 (-)
unnamed: C34.2, R25.1, R29.2, U12.8
unnamed: C35.1, R22.1, R26.2, U13.2 (-)
unnamed: C35.2, R26.1, R30.2, U13.1
unnamed: C36.1, R23.1, R27.2, U13.9 (-)
unnamed: C36.2, R27.1, R31.2, U13.8
unnamed: C37.1, R28.1, R32.2, U12.6 (-)
unnamed: C38.1, R29.1, R33.2, U12.13 (-)
unnamed: C39.1, R30.1, R34.2, U13.6 (-)
unnamed: C40.1, R31.1, R35.2, U13.13 (-)
cv_0: C25.2, R16.1, U10.7; also elsewhere on the board
cv_1: C37.2, R32.1, U12.7; also elsewhere on the board
cv_2: C26.2, R17.1, U11.7; also elsewhere on the board
cv_3: C39.2, R34.1, U13.7; also elsewhere on the board
mod_0: C27.2, R18.1, U10.14; also elsewhere on the board
mod_1: C38.2, R33.1, U12.14; also elsewhere on the board
mod_2: C28.2, R19.1, U11.14; also elsewhere on the board
mod_3: C40.2, R35.1, U13.14; also elsewhere on the board
