lucblender/MultiTool-Midi-Board/Hardware/multi-tool-midi-board/multi-tool-midi-board.kicad_pcb

## KiCad design Hardware/multi-tool-midi-board/multi-tool-midi-board.kicad_pcb (continued)

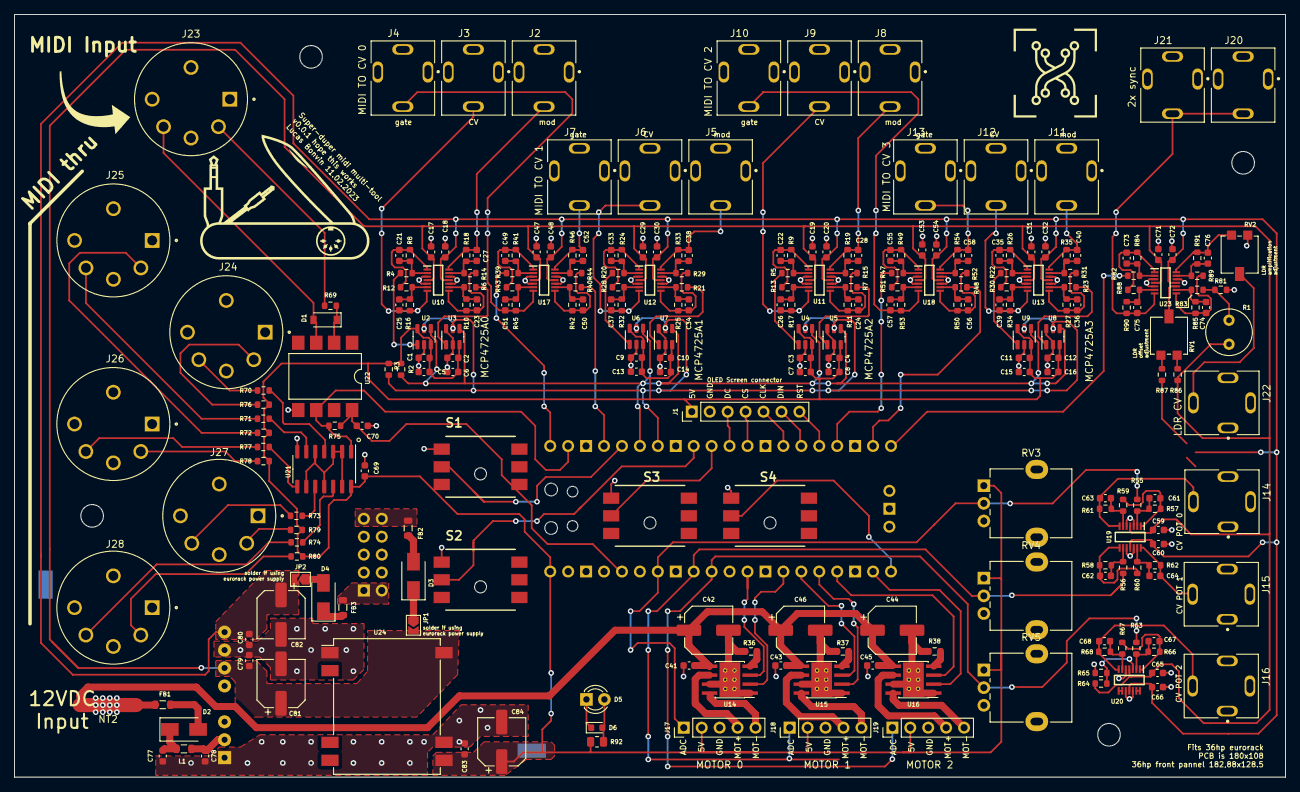
[picture p10: board multi-tool-midi-board.kicad_pcb from above]

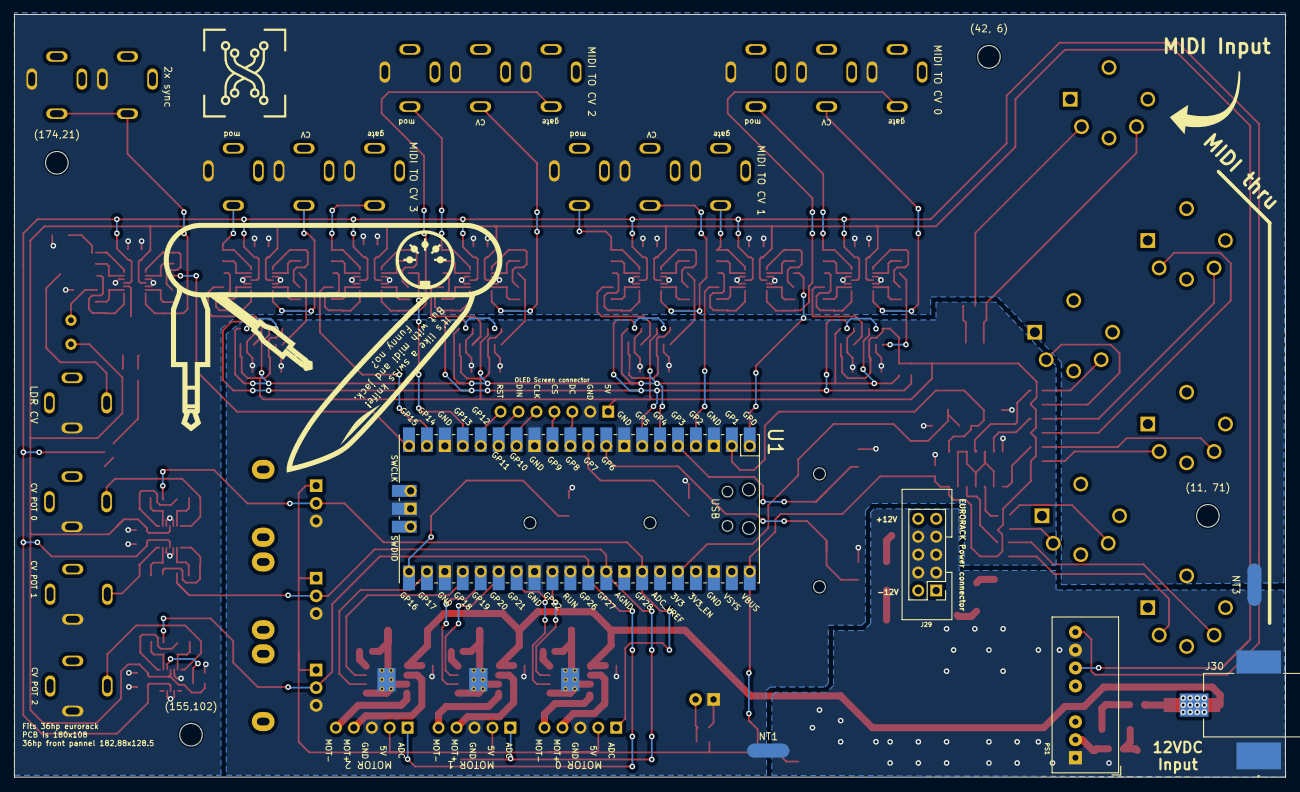
[picture p11: board multi-tool-midi-board.kicad_pcb from below]

Board: 2 copper layers, 180.0 x 108.0 mm, 255 parts (6 on the bottom side), 158 nets.
