lucblender/MultiTool-Midi-Board/Software/SimpleMIDIDecoder.py

# Simple MIDI Decoder
# for Micro Python on the Raspberry Pi Pico
#
# @diyelectromusic
# https://diyelectromusic.wordpress.com/
#
#      MIT License
#      
#      Copyright (c) 2020 diyelectromusic (Kevin)
#      
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
# Example Usage:
#
#---------------------
#    import machine
#    import SimpleMIDIDecoder
#
#    uart = machine.UART(0,31250)
#    md = SimpleMIDIDecoder.SimpleMIDIDecoder()
#
#    while True:
#        if (uart.any()):
#            md.read(uart.read(1)[0])
#---------------------
#
# To add bespoke handling, define callback functions for NoteOn, NoteOff or
# a default "Thru" handling as shown below.
#
#---------------------
#    def doMidiNoteOn(ch,cmd,note,vel):
#        print("Note On \t", note, "\t", vel)
#
#    def doMidiNoteOff(ch,cmd,note,vel):
#        print("Note Off\t", note, "\t", vel)
#
#    def doMidiThru(ch,cmd,data1,data2):
#        print("Thru\t", cmd, "\t", data1, "\t", data2)
#
#    md = SimpleMIDIDecoder.SimpleMIDIDecoder()
#    md.cbNoteOn (doMidiNoteOn)
#    md.cbNoteOff (doMidiNoteOff)
#    md.cbThru (doMidiThru)
#---------------------
#
# It is possible to provide an optional "instance" parameter to the
# decoder on initialisation.  This will be provided to the callback
# as the last parameter.
#
# The following example shows how to run a decoder on both hardware
# serial ports (UARTs) for the Pico.
#
#---------------------
#    import machine
#    import SimpleMIDIDecoder
#
#    uart = []
#    for i in range(2):
#        tmpuart = machine.UART(i,31250)
#        uart.append(tmpuart)
#
#    def doMidiNoteOn(ch,cmd,note,vel,idx):
#        print(idx,"\tNote On \t", note, "\t", vel)
#
#    def doMidiNoteOff(ch,cmd,note,vel,idx):
#        print(idx,"\tNote Off\t", note, "\t", vel)
#
#    def doMidiThru(ch,cmd,data1,data2,idx):
#        print(idx,"\tThru\t", cmd, "\t", data1, "\t", data2)
#
#    md = []
#    for i in range(2):
#        tmpmd = SimpleMIDIDecoder.SimpleMIDIDecoder(i)
#        tmpmd.cbNoteOn (doMidiNoteOn)
#        tmpmd.cbNoteOff (doMidiNoteOff)
#        tmpmd.cbThru (doMidiThru)
#        md.append(tmpmd)
#
#    while True:
#        for i in range(2):
#            if (uart[i].any()):
#                md[i].read(uart[i].read(1)[0])
#---------------------


# Implement a simple MIDI decoder.
#
# MIDI supports the idea of Running Status.
#
# If the command is the same as the previous one, 
# then the status (command) byte doesn't need to be sent again.
#
# The basis for handling this can be found here:
#  http://midi.teragonaudio.com/tech/midispec/run.htm
# Namely:
#   Buffer is cleared (ie, set to 0) at power up.
#   Buffer stores the status when a Voice Category Status (ie, 0x80 to 0xEF) is received.
#   Buffer is cleared when a System Common Category Status (ie, 0xF0 to 0xF7) is received.
#   Nothing is done to the buffer when a RealTime Category message is received.
#   Any data bytes are ignored when the buffer is 0.
#
class SimpleMIDIDecoder:
    
    def __init__(self, idx=-1):
        self.idx = idx
        self.ch = 0
        self.cmd = 0
        self.d1 = 0
        self.d2 = 0
        self.cbThruFn = 0
        self.cbNoteOnFn = 0
        self.cbNoteOffFn = 0
        self.cbClockFn = 0
        self.cbMidiStartFn = 0
        self.cbMidiStopFn = 0
        
    def cbThru (self, callback):
        self.cbThruFn = callback

    def ThruFn (self, ch, cmd, d1, d2, idx):
        if (self.cbThruFn):
            if (idx != -1):
                self.cbThruFn(ch, cmd, d1, d2, idx)
            else:
                self.cbThruFn(ch, cmd, d1, d2)
        else:
            # Default THRU behaviour
            if (d2 == -1):
                print ("Thru ", ch, ":", hex(cmd), ":", d1)
            else:
                print ("Thru ", ch, ":", hex(cmd), ":", d1, ":", d2)
        
    def cbNoteOn (self, callback):
        self.cbNoteOnFn = callback
    
    def NoteOnFn (self, ch, cmd, note, level, idx):
        if (self.cbNoteOnFn):
            if (idx != -1):
                self.cbNoteOnFn(ch, cmd, note, level, idx)
            else:
                self.cbNoteOnFn(ch, cmd, note, level)
        else:
            # Default NoteOn behaviour
            print ("NoteOn ", ch, ":", note, ":", level)

    def cbNoteOff (self, callback):
        self.cbNoteOffFn = callback

    def NoteOffFn (self, ch, cmd, note, level, idx):
        if (self.cbNoteOffFn):
            if (idx != -1):
                self.cbNoteOffFn(ch, cmd, note, level, idx)
            else:
                self.cbNoteOffFn(ch, cmd, note, level)
        else:
            # Default NoteOff behaviour
            print ("NoteOff ", ch, ":", note, ":", level)
            
    def cbClock (self, callback):
        self.cbClockFn = callback

    def ClockFn(self):
        if (self.cbClockFn):
            self.cbClockFn()
        else:
            # Default ClockFn behaviour
            print ("Midi clock")
            
    def cbMidiStart(self, callback):
        self.cbClockFn = callback

    def MidiStartFn (self):
        if (self.cbMidiStartFn):
            self.cbMidiStartFn()
        else:
            # Default MidiStartFn behaviour
            print ("Midi Start")
            
    def cbMidiStop(self, callback):
        self.cbMidiStopFn = callback

    def MidiStopFn (self):
        if (self.cbMidiStopFn):
            self.cbMidiStopFn()
        else:
            # Default MidiStopFn behaviour
            print ("Midi Stop")
        
    def read(self, mb):
        if ( mb ==  0xF8):
            self.ClockFn()
        elif ( mb ==  0xFA):
            self.MidiStartFn()
        elif (mb == 0xFC):
            self.MidiStopFn() 
        elif ((mb >= 0x80) and (mb <= 0xEF)):
            # MIDI Voice Category Message.
            # Action: Start handling Running Status
            
            # Extract the MIDI command and channel (1-16)
            self.cmd = mb & 0xF0
            self.ch = 1 + mb & 0x0F
            
            # Initialise the two data bytes ready for processing
            self.d1 = 0
            self.d2 = 0
        elif ((mb >= 0xF0) and (mb <= 0xF7)):
            # MIDI System Common Category Message.
            # These are not handled by this decoder.
            # Action: Reset Running Status.
            self.cmd = 0
        elif ((mb >= 0xF8) and (mb <= 0xFF)):
            # System Real-Time Message.
            # These are not handled by this decoder.
            # Action: Ignore these.
            pass
        else:
            # MIDI Data
            if (self.cmd == 0):
                # No record of what state we're in, so can go no further
                return
            if (self.cmd == 0x80):
                # Note OFF Received
                if (self.d1 == 0):
                    # Store the note number
                    self.d1 = mb
                else:
                    # Already have the note, so store the level
                    self.d2 = mb
                    self.NoteOffFn (self.ch, self.cmd, self.d1, self.d2, self.idx)
                    self.d1 = 0
                    self.d2 = 0
            elif (self.cmd == 0x90):
                # Note ON Received
                if (self.d1 == 0):
                    # Store the note number
                    self.d1 = mb
                else:
                    # Already have the note, so store the level
                    self.d2 = mb
                    # Special case if the level (data2) is zero - treat as NoteOff
                    if (self.d2 == 0):
                        self.NoteOffFn (self.ch, self.cmd, self.d1, self.d2, self.idx)
                    else:
                        self.NoteOnFn (self.ch, self.cmd, self.d1, self.d2, self.idx)
                    self.d1 = 0
                    self.d2 = 0
            elif (self.cmd == 0xC0):
                # Program Change
                # This is a single data-byte message
                self.d1 = mb
                self.ThruFn(self.ch, self.cmd, self.d1, -1, self.idx)
                self.d1 = 0
            elif (self.cmd == 0xD0):
                # Channel Pressure
                # This is a single data-byte message
                self.d1 = mb
                self.ThruFn(self.ch, self.cmd, self.d1, -1, self.idx)
                self.d1 = 0
            else:
                # All other commands are two-byte data commands
                if (self.d1 == 0):
                    # Store the first data byte
                    self.d1 = mb
                else:
                    # Store the second data byte and action
                    self.d2 = mb
                    self.ThruFn(self.ch, self.cmd, self.d1, self.d2, self.idx)
                    self.d1 = 0
                    self.d2 = 0
