lucblender/MultiTool-Midi-Board/(commit log)

2023-04-30 first commit of kicad projects
    [multi-tool-midi-adc.kicad_sch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]
2023-05-02 add thread for midi and nice screensaver
2023-05-06 change visualisation of -5 5V pot
2023-05-18 add data saving, velocity out instead of mod, debug screen at boot
2023-05-19 add motorized potentiometer presets
